RangeMaster370/kicad-sensor-interface-board/results/schematic.pdf

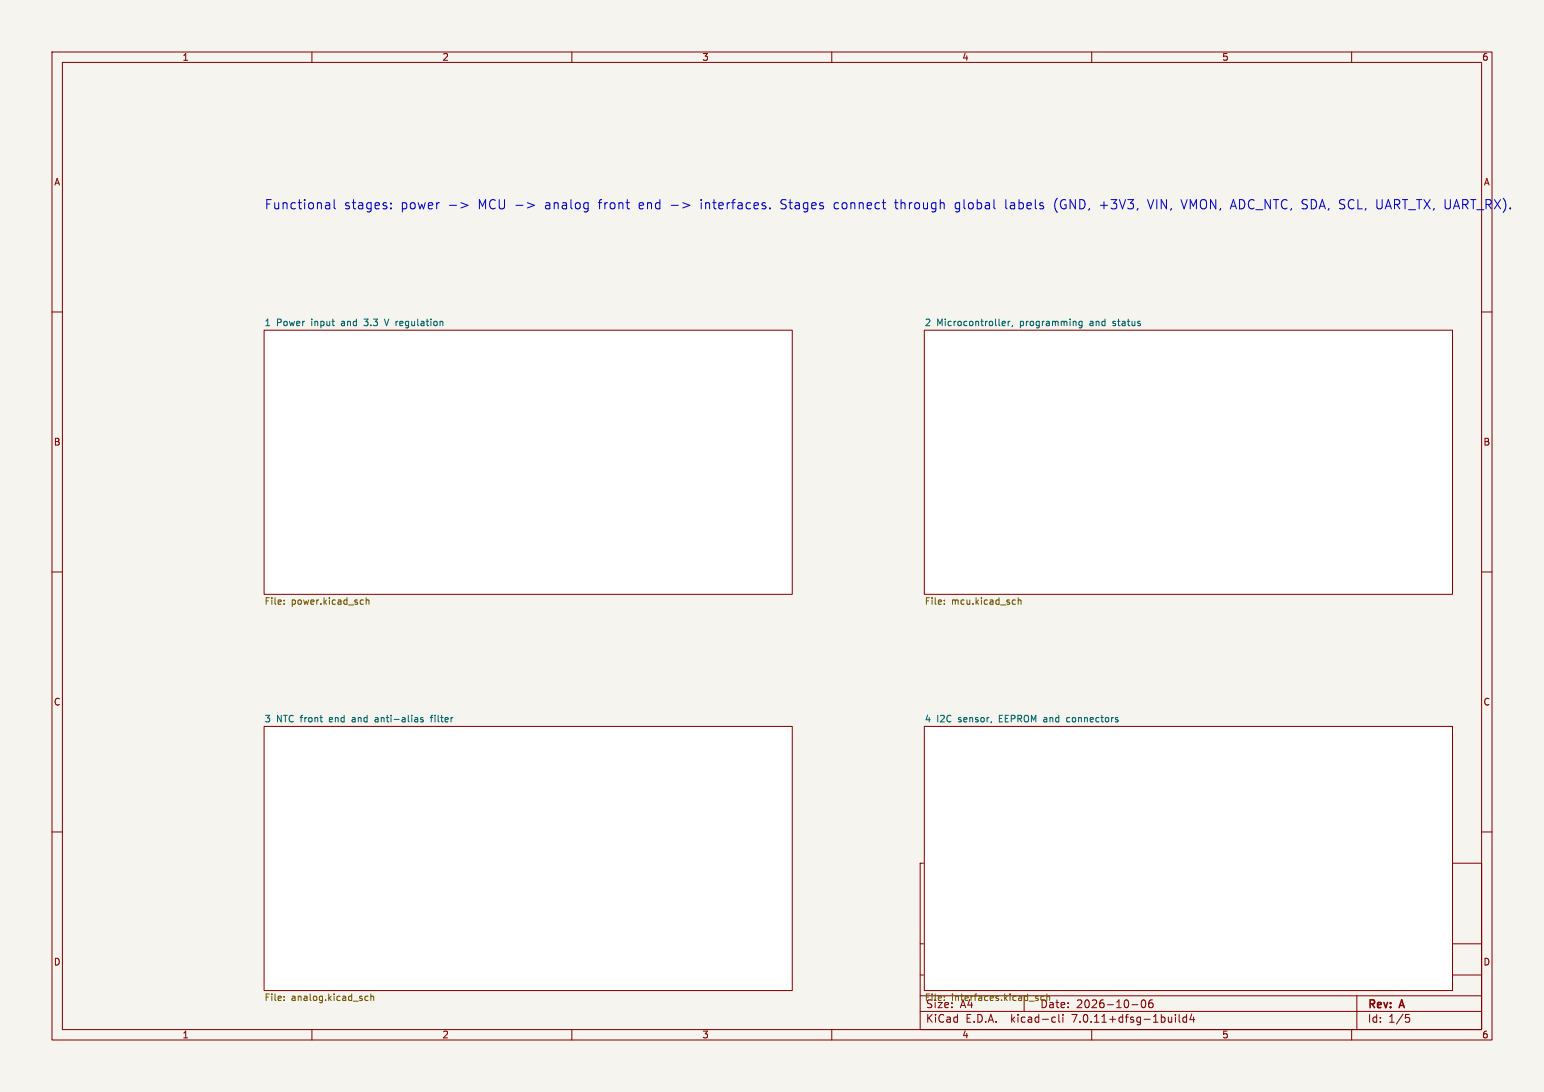
[picture p1: page 1]

1 Power input and 3.3 V regulation File: power.kicad_sch

4 I2C sensor, EEPROM and connectors File: interfaces.kicad_sch

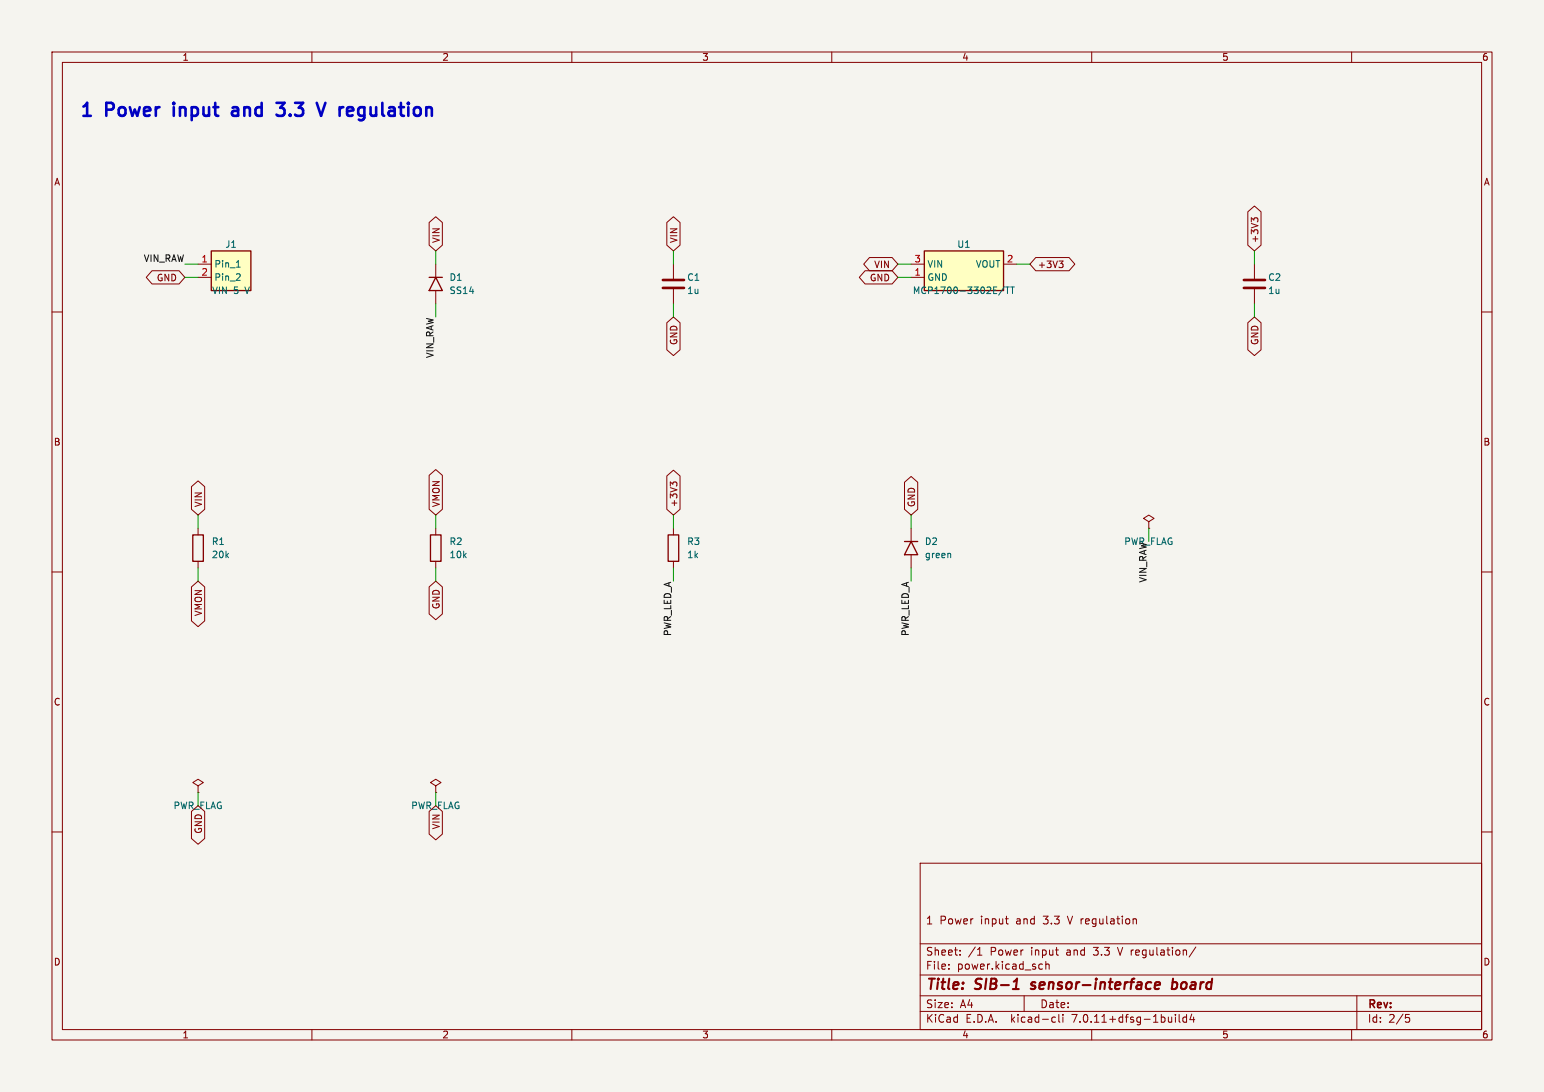
[picture p2: page 2]

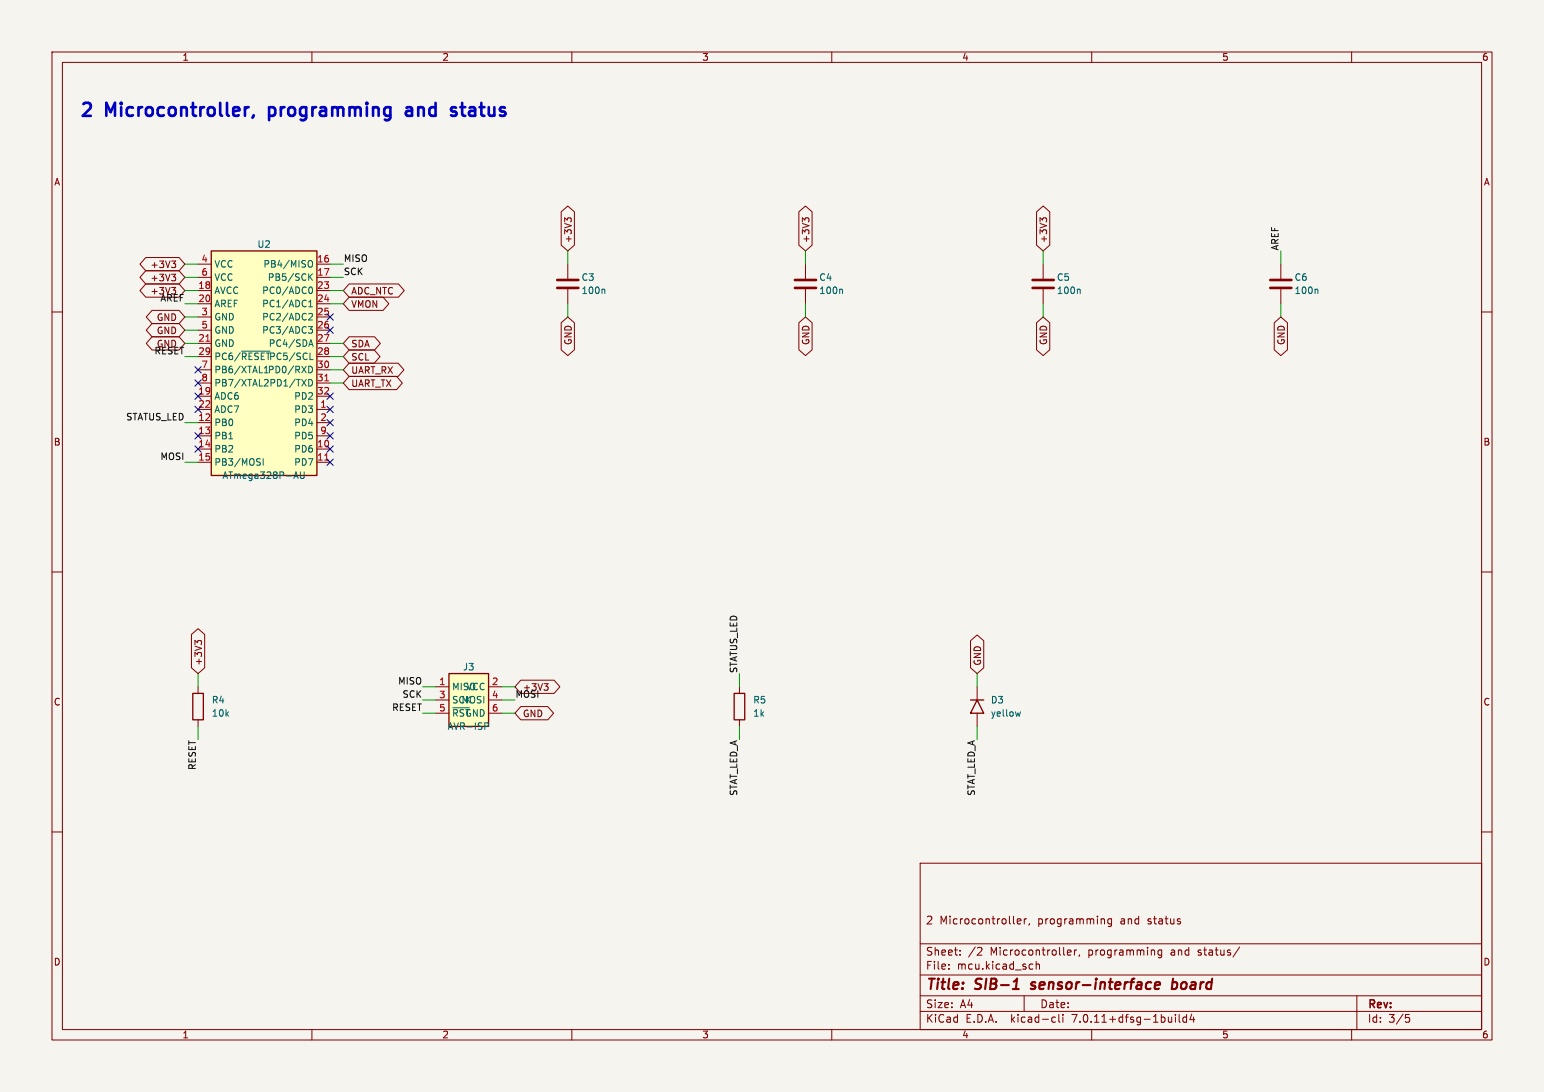
[picture p3: page 3]

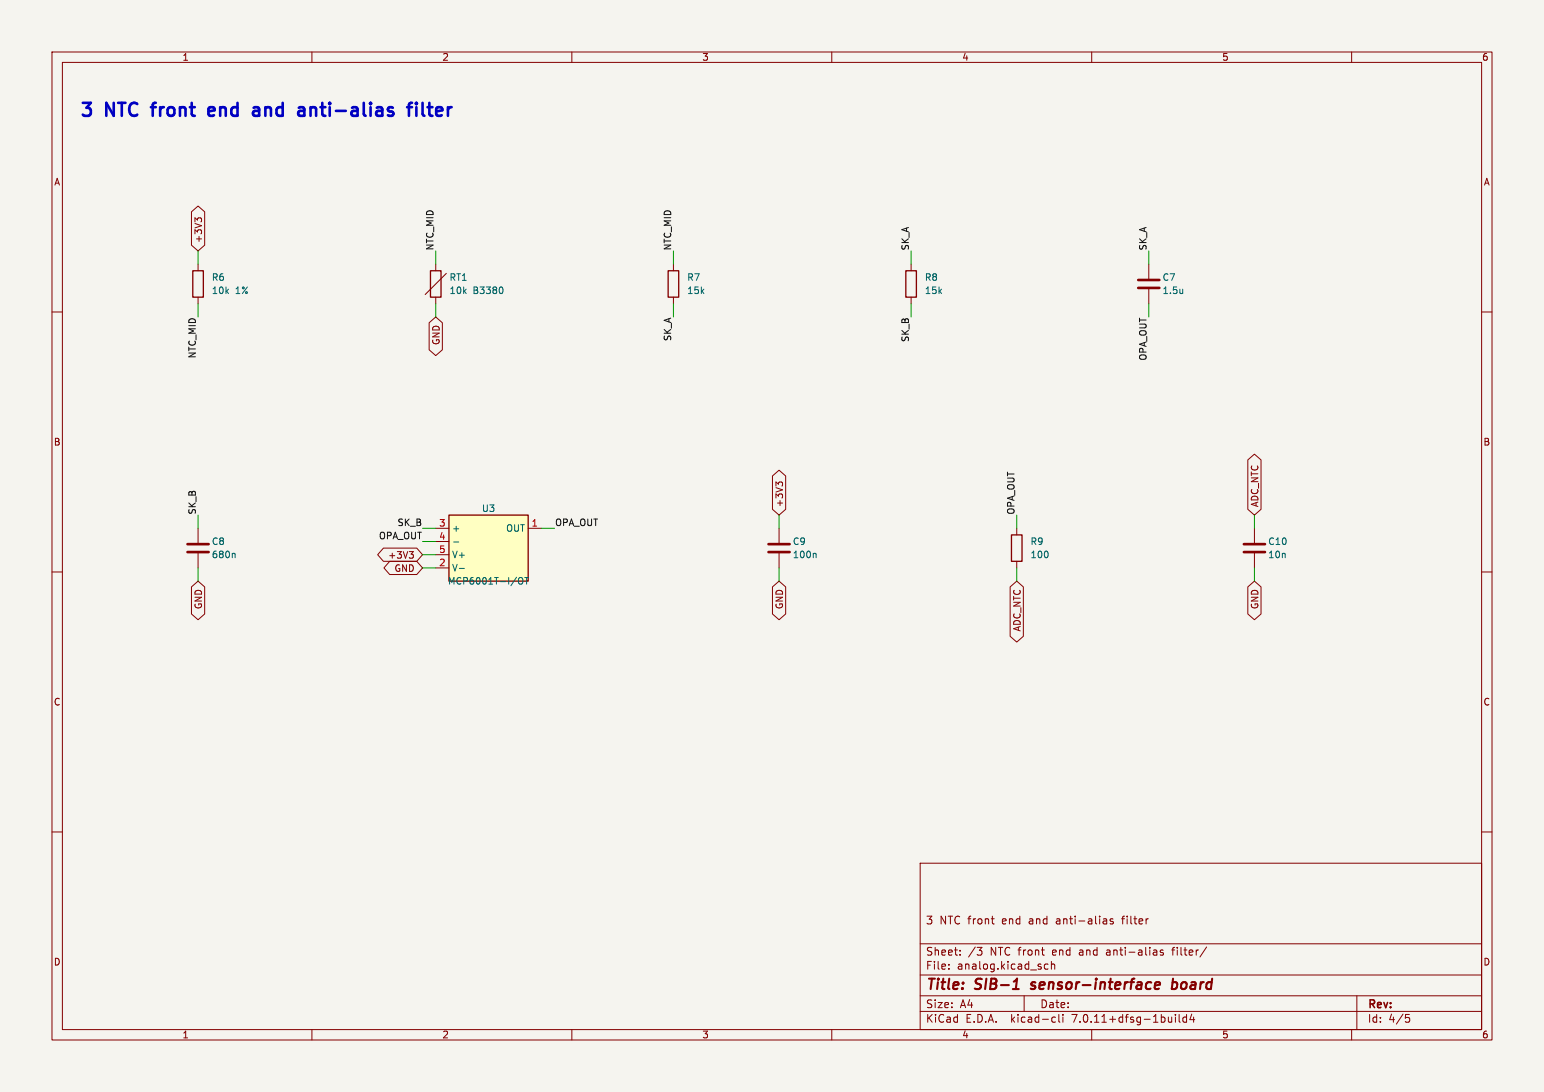
[picture p4: page 4]

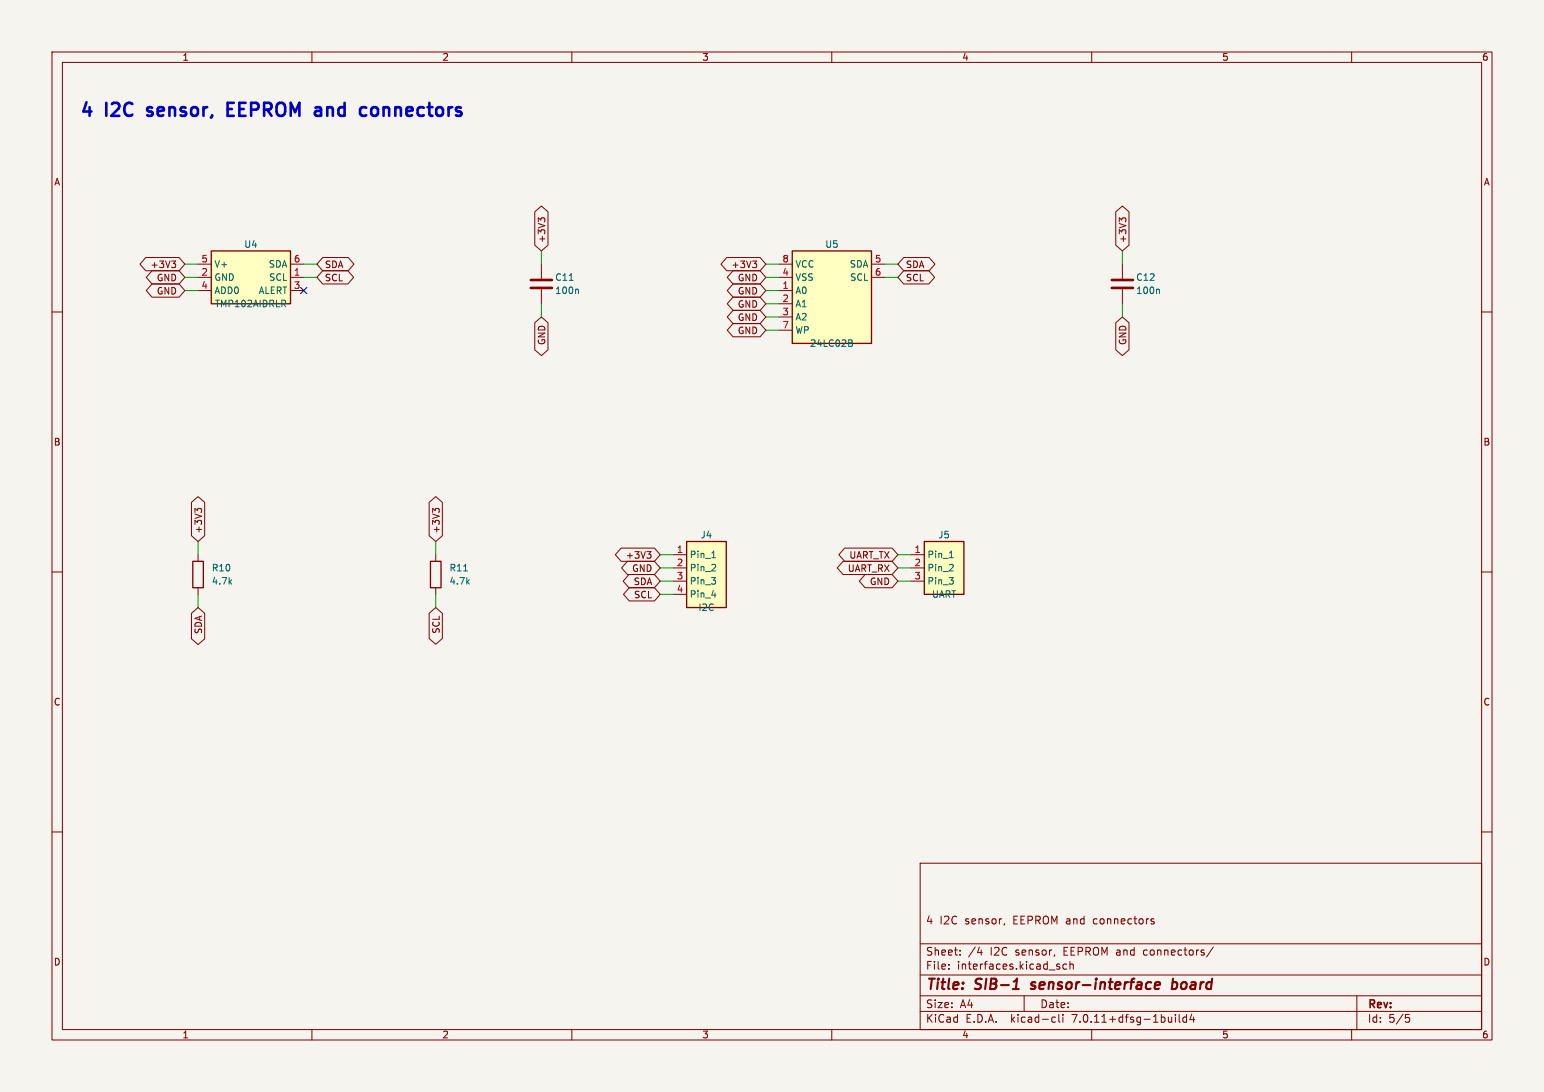
[picture p5: page 5]
