RangeMaster370/kicad-sensor-interface-board/hardware/sib.kicad_pcb

## KiCad design hardware/sib.kicad_pcb (2026-10-06)

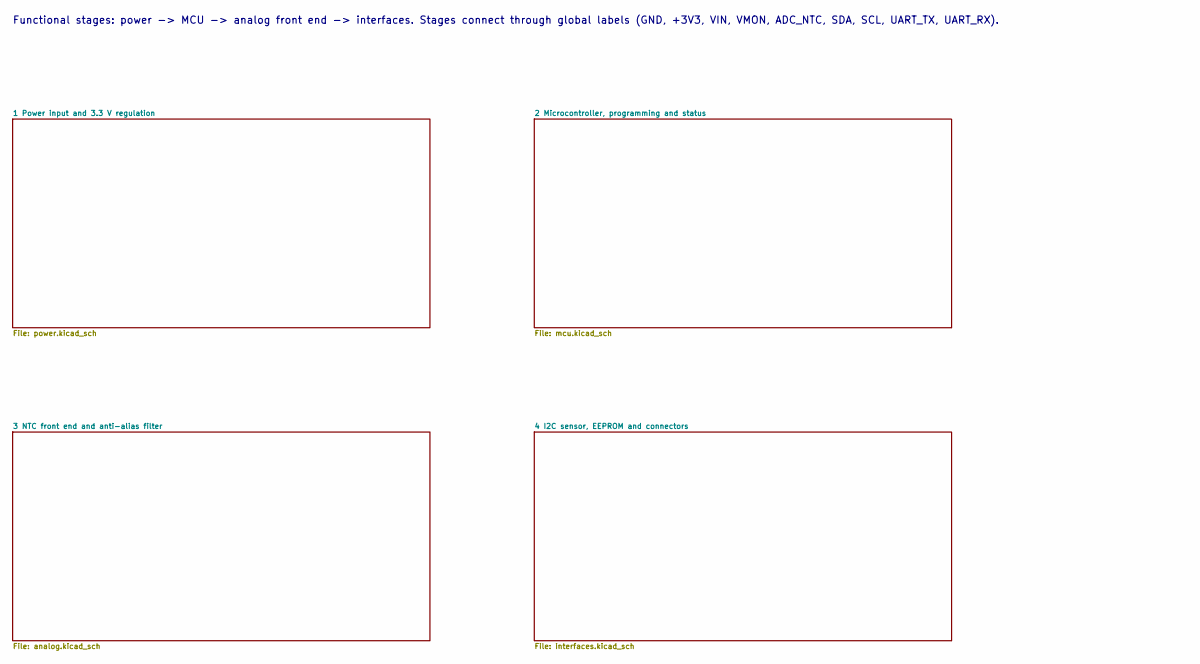
[picture p6: schematic sib.kicad_sch, SIB-1 sensor-interface board]

Notes on the sheet:
Functional stages: power -> MCU -> analog front end -> interfaces. Stages connect through global labels (GND, +3V3, VIN, VMON, ADC_NTC, SDA, SCL, UART_TX, UART_RX).

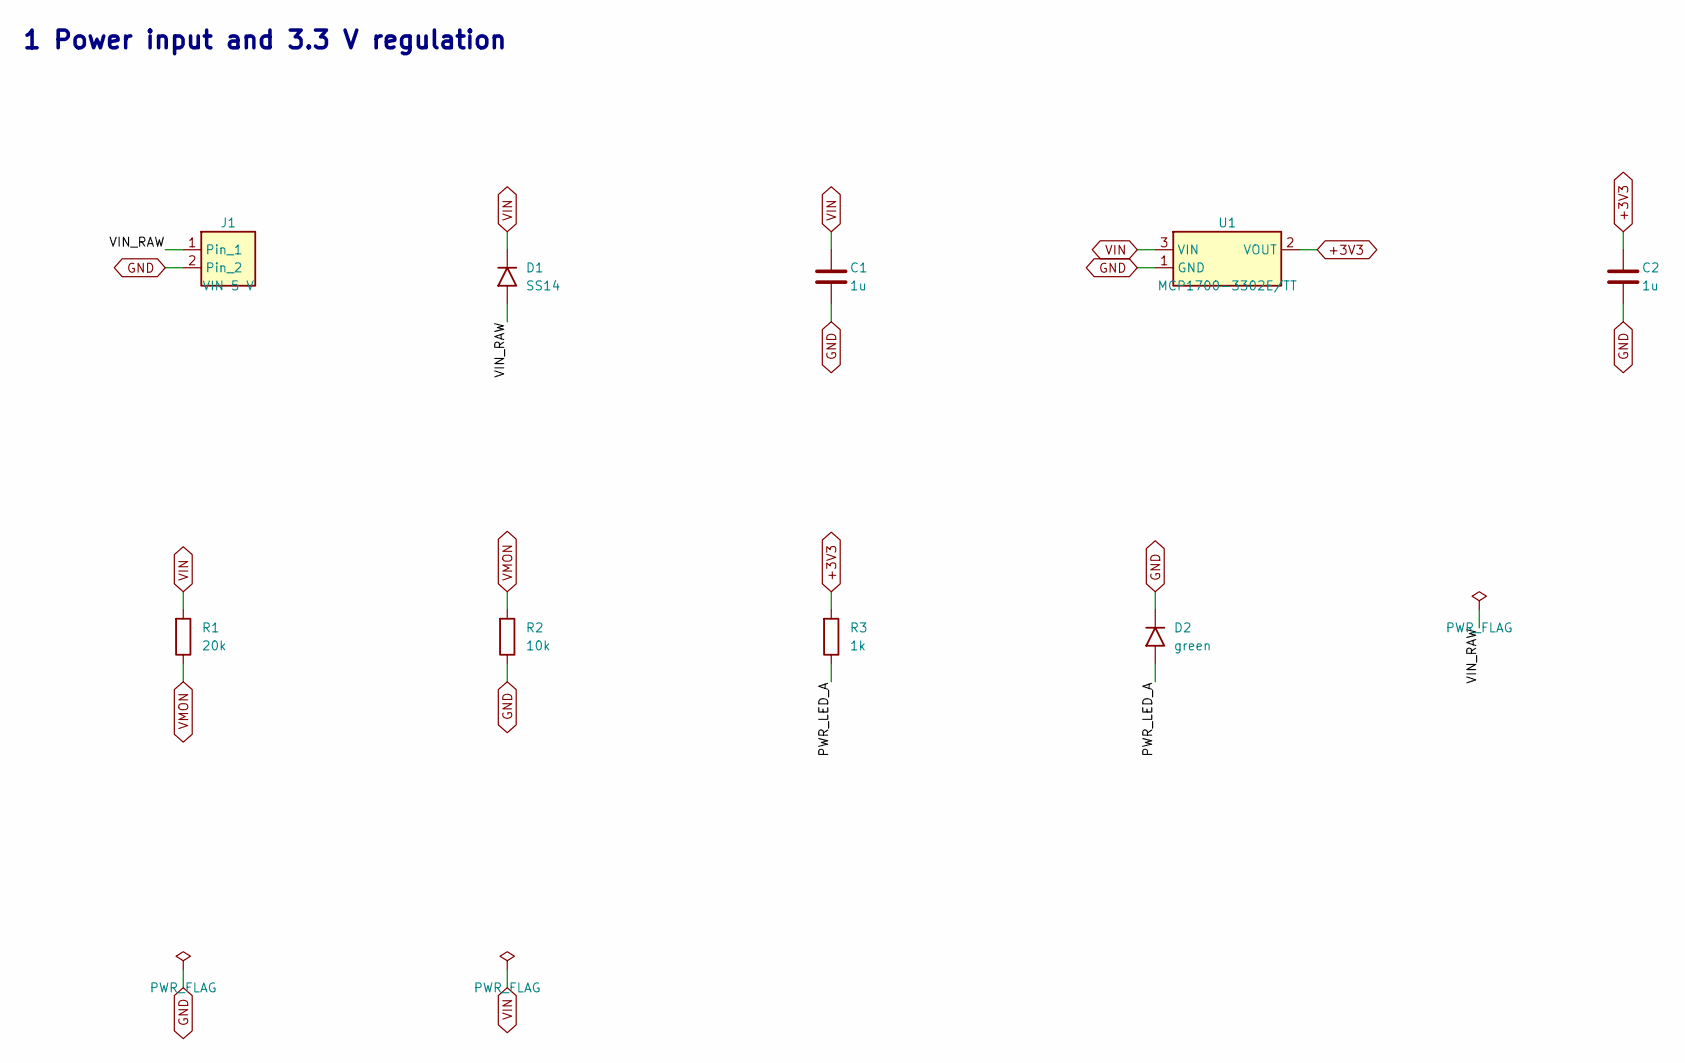
[picture p7: schematic power.kicad_sch, SIB-1 sensor-interface board]

Parts:
C1, C2: 1u; C_0603; MPN GRM188R61E105KA12
D1: SS14; D_SMA; MPN SS14
D2: green; LED_0603; MPN LTST-C191KGKT
J1: VIN 5 V; PinHeader_1x02_P2.54mm; MPN 2.54 mm header
R1: 20k; R_0603; MPN RC0603FR-0720KL
R2: 10k; R_0603; MPN RC0603FR-0710KL
R3: 1k; R_0603; MPN RC0603FR-071KL
U1: MCP1700-3302E/TT; SOT-23; MPN MCP1700T-3302E/TT

Connections:
+3V3: C2.1, R3.1, U1.2 (VOUT); also elsewhere on the board
GND: C1.2, C2.2, D2.1 (K), J1.2, R2.2, U1.1 (GND); also elsewhere on the board
PWR_LED_A: D2.2 (A), R3.2
VIN: C1.1, D1.1 (K), R1.1, U1.3 (VIN)
VIN_RAW: D1.2 (A), J1.1
VMON: R1.2, R2.1; also elsewhere on the board

Notes on the sheet:
1 Power input and 3.3 V regulation

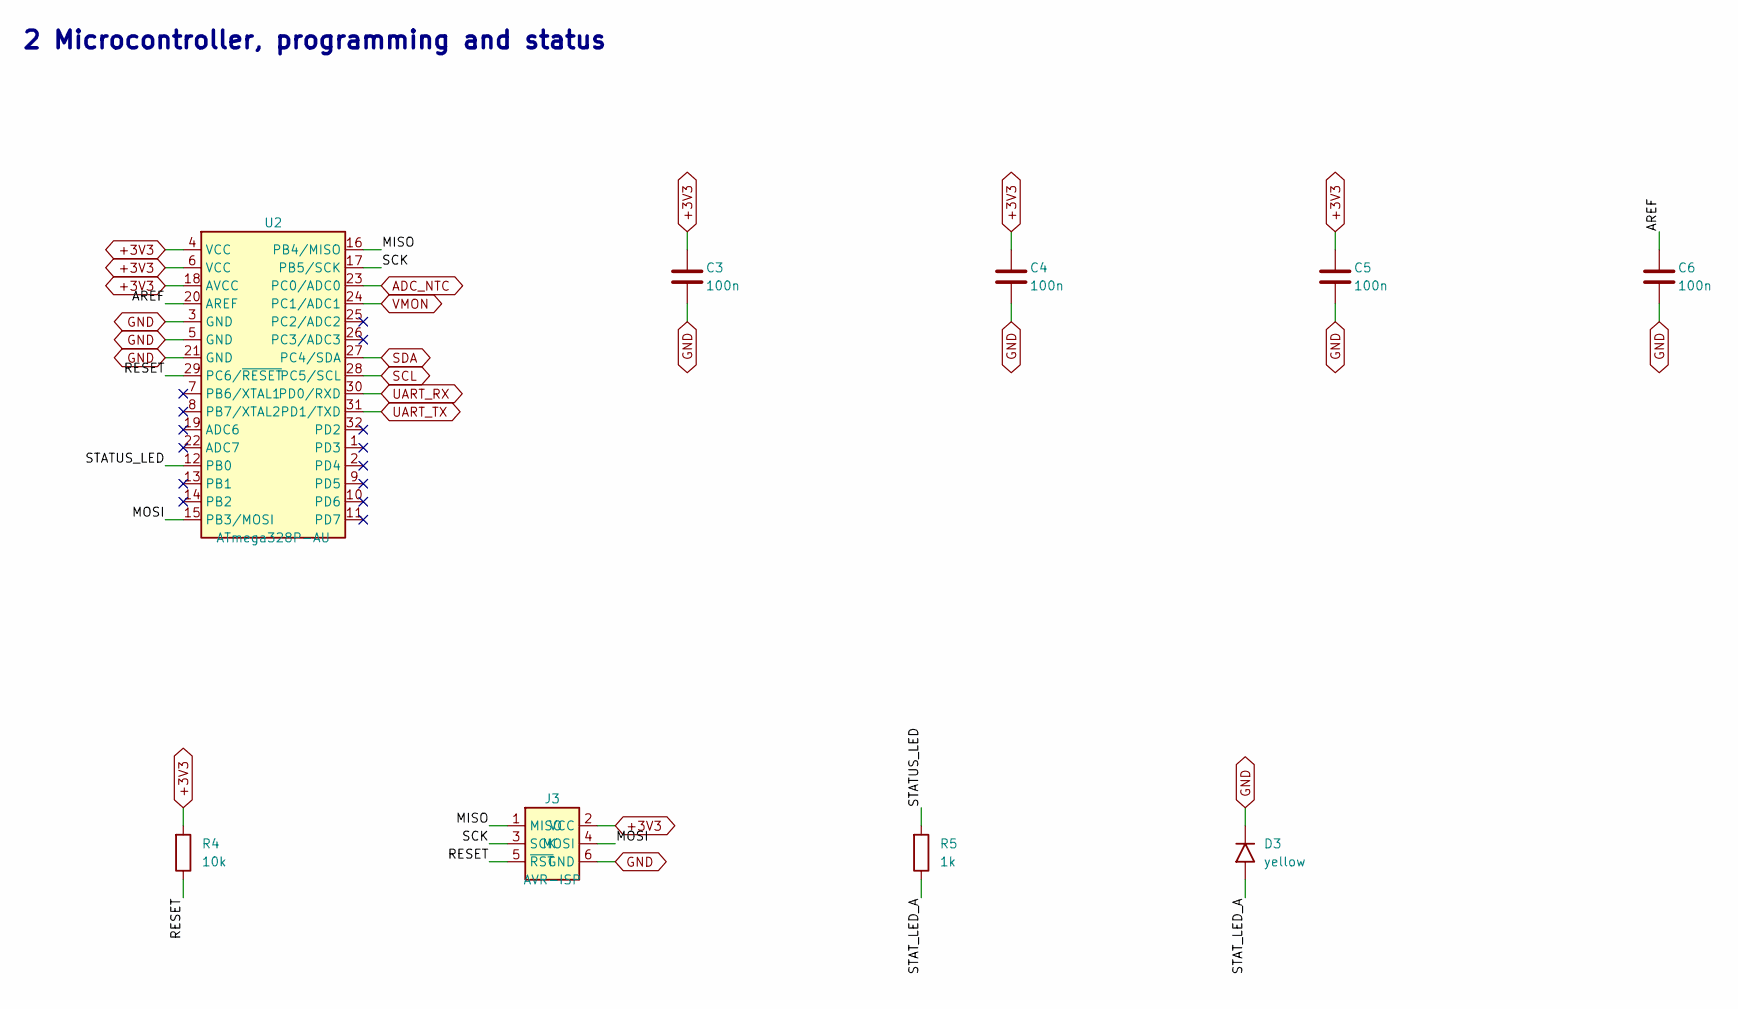
[picture p8: schematic mcu.kicad_sch, SIB-1 sensor-interface board]

Parts:
C3, C4, C5, C6: 100n; C_0603; MPN GRM188R71H104KA93
D3: yellow; LED_0603; MPN LTST-C191KSKT
J3: AVR-ISP; PinHeader_2x03_P2.54mm; MPN 2x3 header
R4: 10k; R_0603; MPN RC0603FR-0710KL
R5: 1k; R_0603; MPN RC0603FR-071KL
U2: ATmega328P-AU; TQFP-32_7x7mm_P0.8mm; MPN ATMEGA328P-AU

Connections:
+3V3: C3.1, C4.1, C5.1, J3.2 (VCC), R4.1, U2.4 (VCC), U2.6 (VCC), U2.18 (AVCC); also elsewhere on the board
ADC_NTC: U2.23 (PC0/ADC0); also elsewhere on the board
AREF: C6.1, U2.20 (AREF)
GND: C3.2, C4.2, C5.2, C6.2, D3.1 (K), J3.6 (GND), U2.3 (GND), U2.5 (GND), U2.21 (GND); also elsewhere on the board
MISO: J3.1 (MISO), U2.16 (PB4/MISO)
MOSI: J3.4 (MOSI), U2.15 (PB3/MOSI)
RESET: J3.5 (~RST), R4.2, U2.29 (PC6/~RESET)
SCK: J3.3 (SCK), U2.17 (PB5/SCK)
SCL: U2.28 (PC5/SCL); also elsewhere on the board
SDA: U2.27 (PC4/SDA); also elsewhere on the board
STATUS_LED: R5.1, U2.12 (PB0)
STAT_LED_A: D3.2 (A), R5.2
UART_RX: U2.30 (PD0/RXD); also elsewhere on the board
UART_TX: U2.31 (PD1/TXD); also elsewhere on the board
VMON: U2.24 (PC1/ADC1); also elsewhere on the board

Notes on the sheet:
2 Microcontroller, programming and status

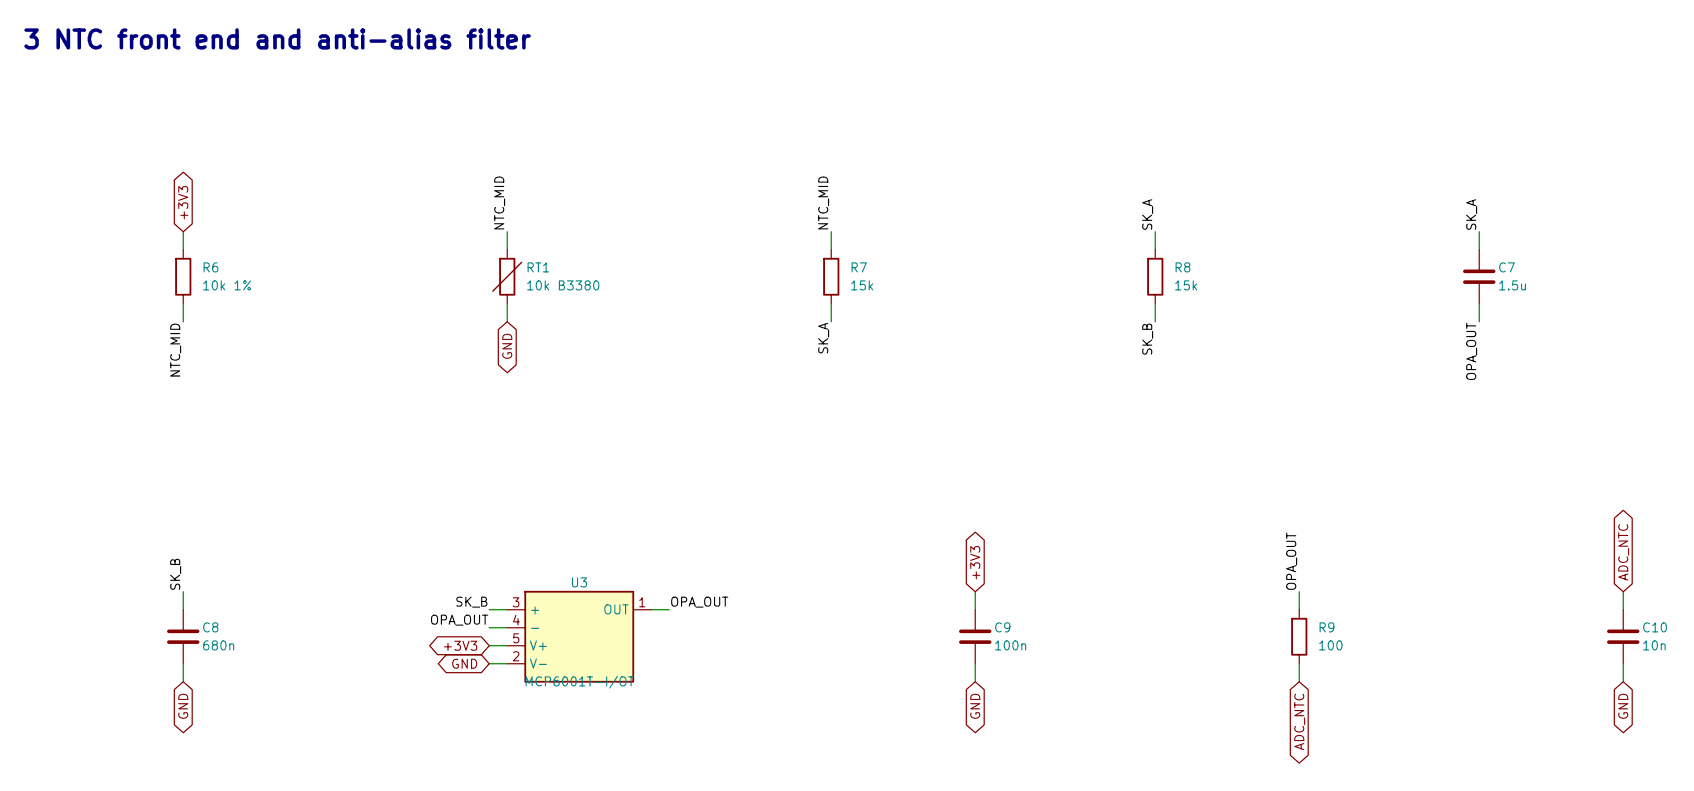
[picture p9: schematic analog.kicad_sch, SIB-1 sensor-interface board]

Parts:
C7: 1.5u; C_0805; MPN GRM21BR71C155KA01
C8: 680n; C_0603; MPN GRM188R71C684KA01
C9: 100n; C_0603; MPN GRM188R71H104KA93
C10: 10n; C_0603; MPN GRM188R71H103KA01
R6: 10k 1%; R_0603; MPN RC0603FR-0710KL
R7, R8: 15k; R_0603; MPN RC0603FR-0715KL
R9: 100; R_0603; MPN RC0603FR-07100RL
RT1: 10k B3380; R_0603; MPN NCP18XH103F03RB
U3: MCP6001T-I/OT; SOT-23-5; MPN MCP6001T-I/OT

Connections:
+3V3: C9.1, R6.1, U3.5 (V+); also elsewhere on the board
ADC_NTC: C10.1, R9.2; also elsewhere on the board
GND: C8.2, C9.2, C10.2, RT1.2, U3.2 (V-); also elsewhere on the board
NTC_MID: R6.2, R7.1, RT1.1
OPA_OUT: C7.2, R9.1, U3.1 (OUT), U3.4 (-)
SK_A: C7.1, R7.2, R8.1
SK_B: C8.1, R8.2, U3.3 (+)

Notes on the sheet:
3 NTC front end and anti-alias filter

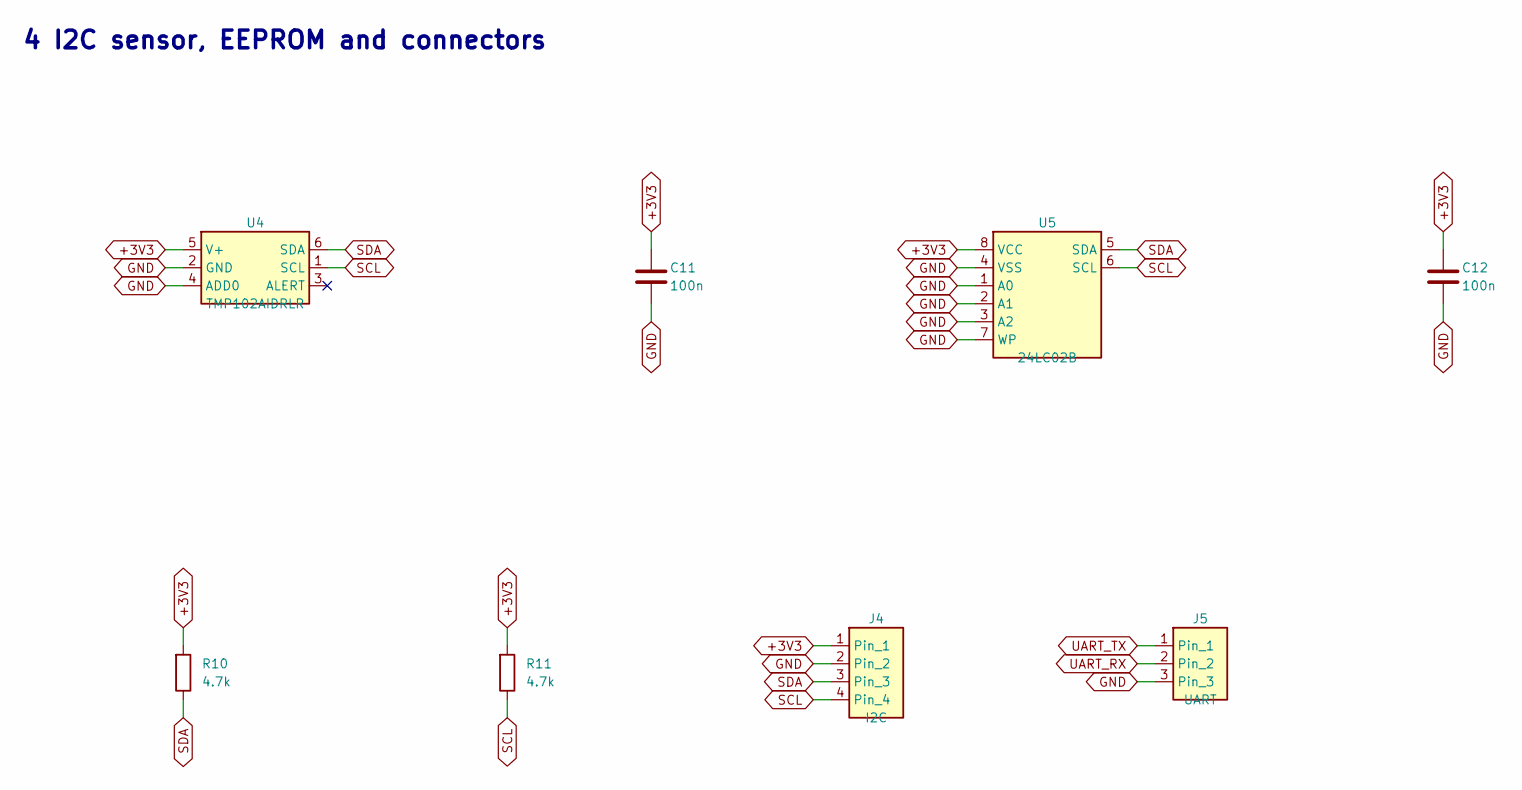
[picture p10: schematic interfaces.kicad_sch, SIB-1 sensor-interface board]

Parts:
C11, C12: 100n; C_0603; MPN GRM188R71H104KA93
J4: I2C; PinHeader_1x04_P2.54mm; MPN 2.54 mm header
J5: UART; PinHeader_1x03_P2.54mm; MPN 2.54 mm header
R10, R11: 4.7k; R_0603; MPN RC0603FR-074K7L
U4: TMP102AIDRLR; SOT-563; MPN TMP102AIDRLR
U5: 24LC02B; SOIC-8_3.9x4.9mm_P1.27mm; MPN 24LC02BT-I/SN

Connections:
+3V3: C11.1, C12.1, J4.1, R10.1, R11.1, U4.5 (V+), U5.8 (VCC); also elsewhere on the board
GND: C11.2, C12.2, J4.2, J5.3, U4.2 (GND), U4.4 (ADD0), U5.1 (A0), U5.2 (A1), U5.3 (A2), U5.4 (VSS), U5.7 (WP); also elsewhere on the board
SCL: J4.4, R11.2, U4.1 (SCL), U5.6 (SCL); also elsewhere on the board
SDA: J4.3, R10.2, U4.6 (SDA), U5.5 (SDA); also elsewhere on the board
UART_RX: J5.2; also elsewhere on the board
UART_TX: J5.1; also elsewhere on the board

Notes on the sheet:
4 I2C sensor, EEPROM and connectors

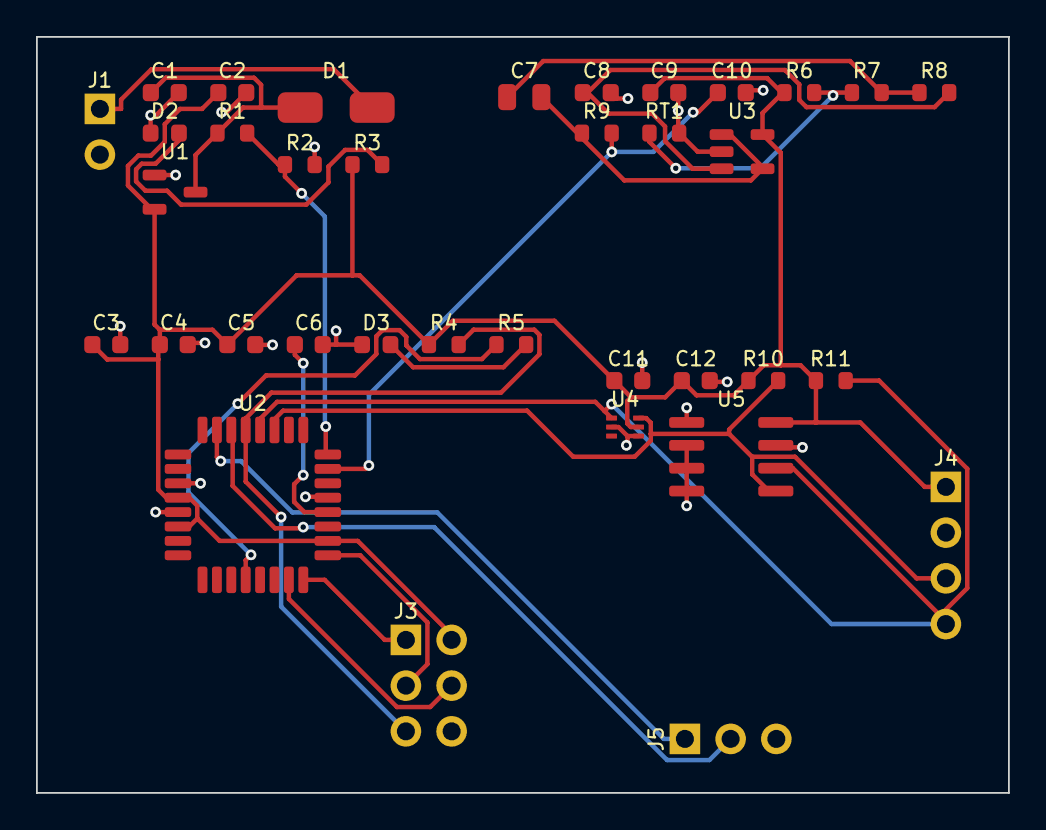
[picture p11: board sib.kicad_pcb from above]

Board: 2 copper layers, 54.0 x 42.0 mm, 36 parts (0 on the bottom side), 22 nets.
